sjgray/OSI600D-colour/_pics/Render-top.jpg

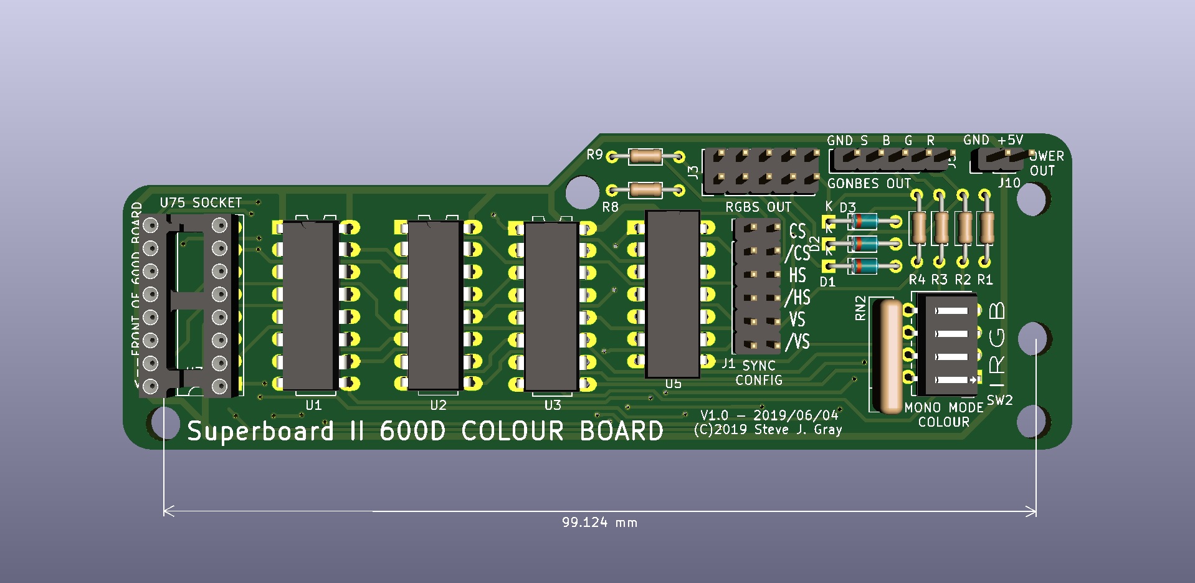
_pics/Render-top.jpg
