sjgray/OSI600D-colour/_pics/Proto1.jpg

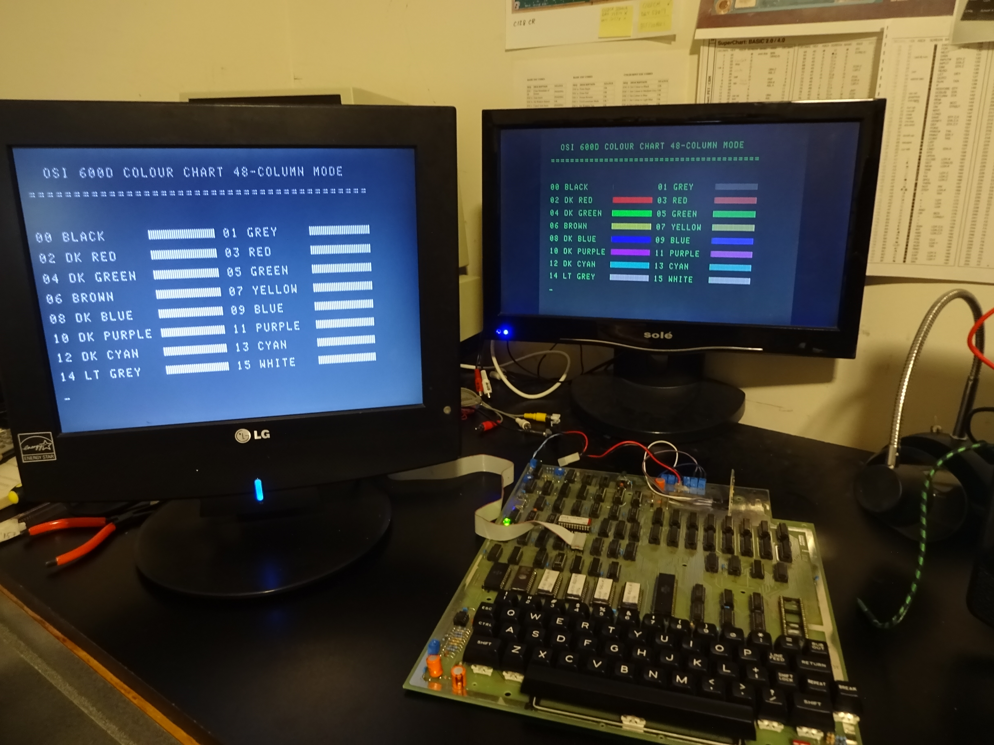
_pics/Proto1.jpg
