sjgray/OSI600D-colour/_pics/ColourChart-24.jpg

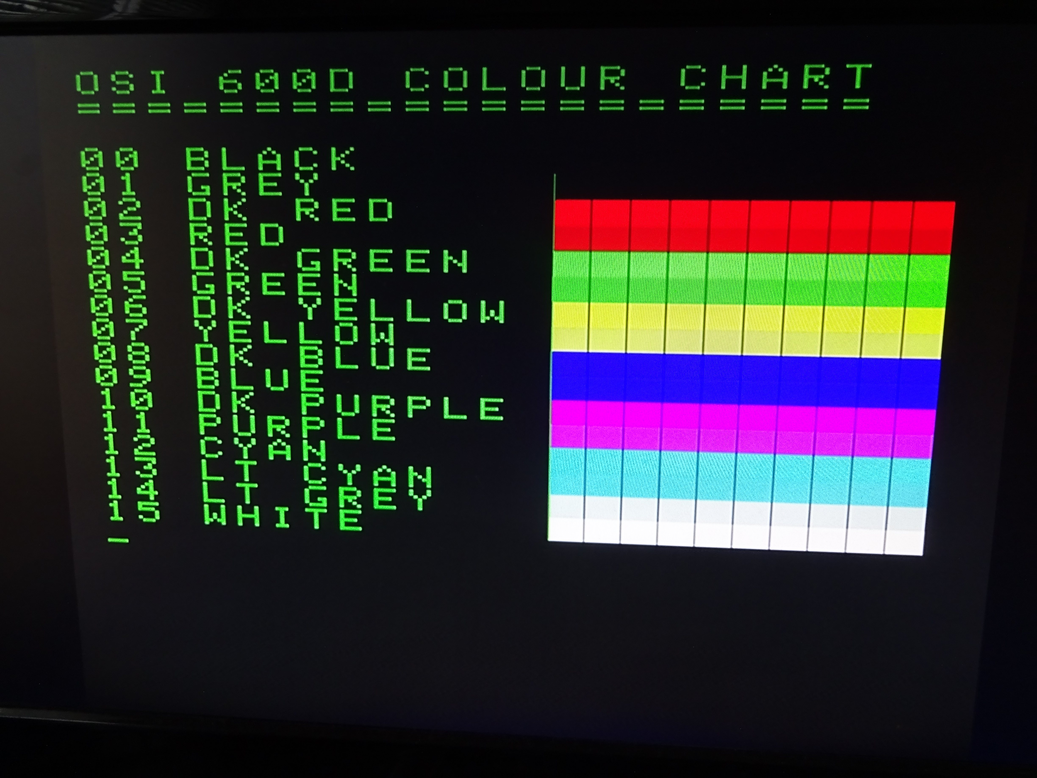
_pics/ColourChart-24.jpg
