sjgray/OSI600D-colour/_pics/ColourChart-48.jpg

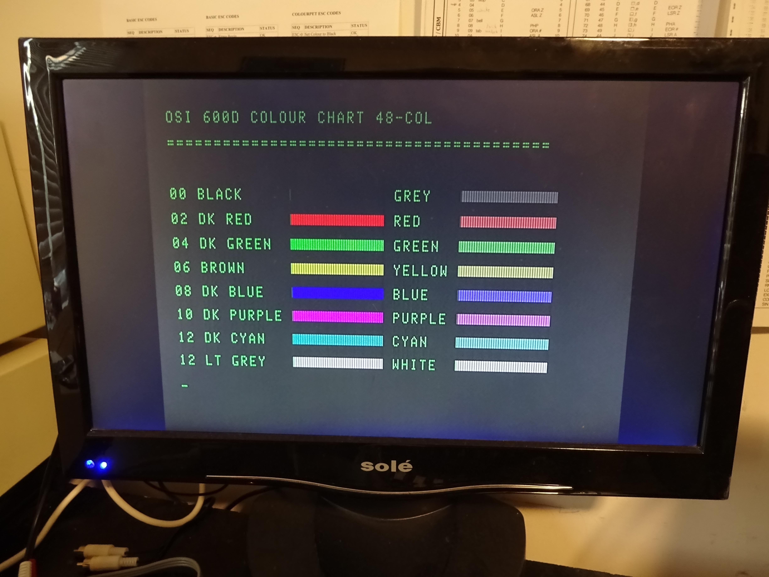
_pics/ColourChart-48.jpg
