sjgray/OSI600D-colour/_pics/Jumper.jpg

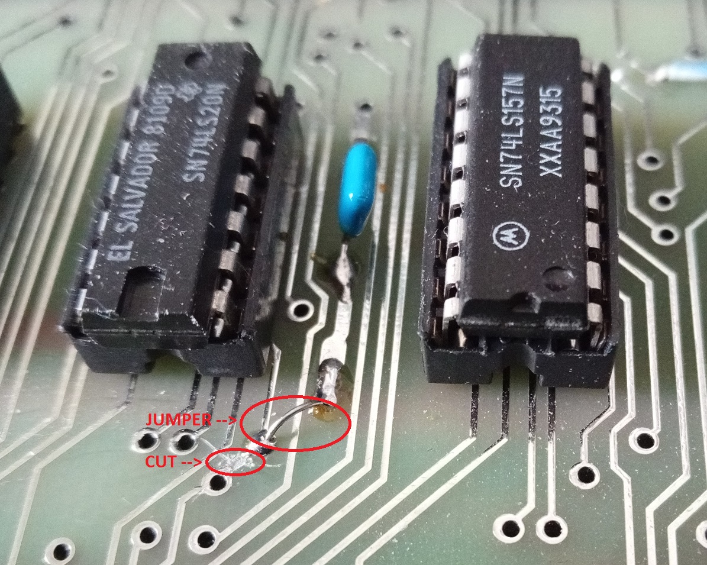
_pics/Jumper.jpg
