sjgray/OSI600D-colour/_pics/Render-angle.jpg

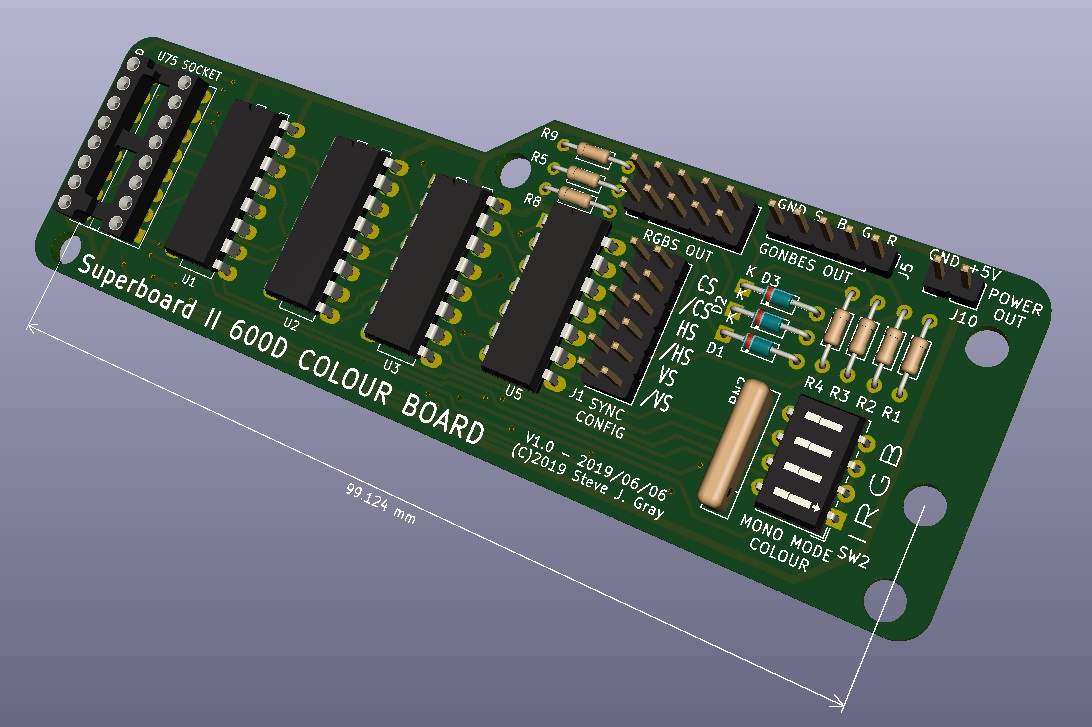
_pics/Render-angle.jpg
