sjgray/OSI600D-colour/_pics/Routing.jpg

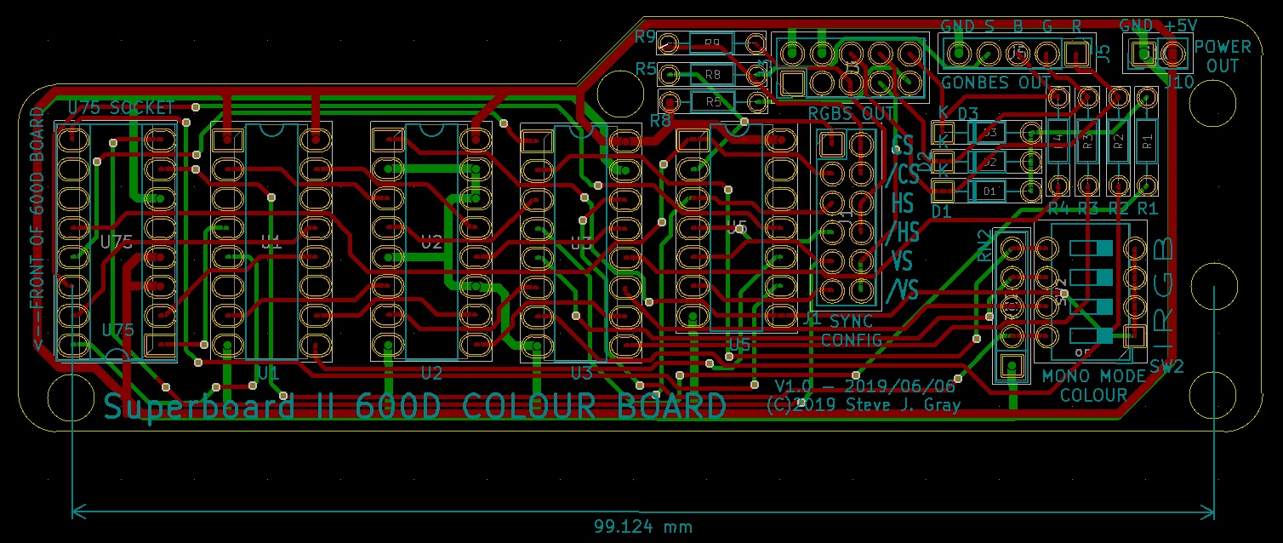
_pics/Routing.jpg
