sjgray/OSI600D-colour/_pics/Schematic.jpg

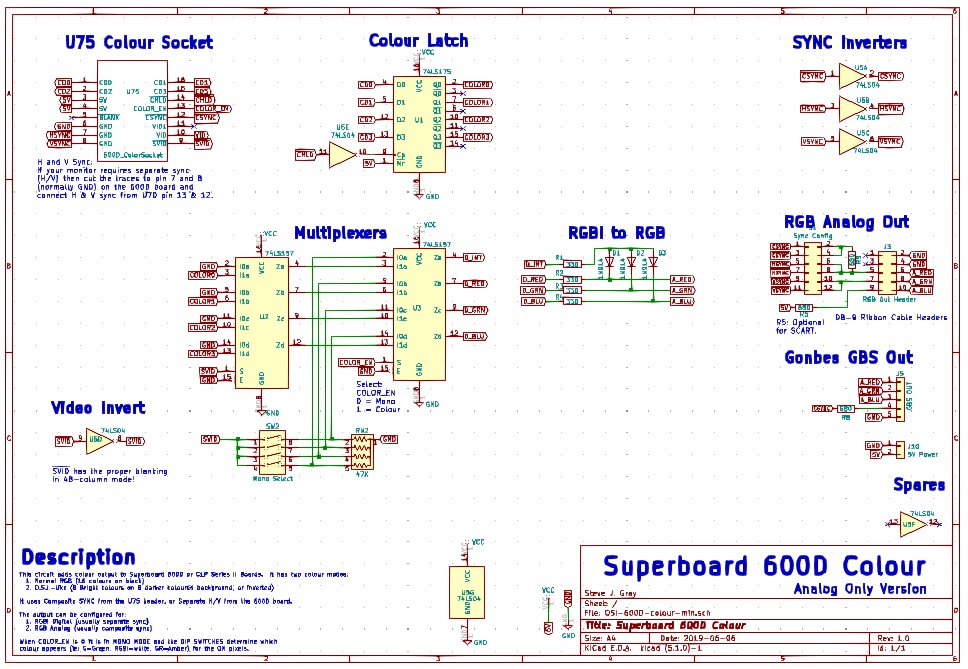
_pics/Schematic.jpg
