sjgray/OSI600D-colour/_pics/WinOSI C4P-Composite vs 600D-RGB.jpg

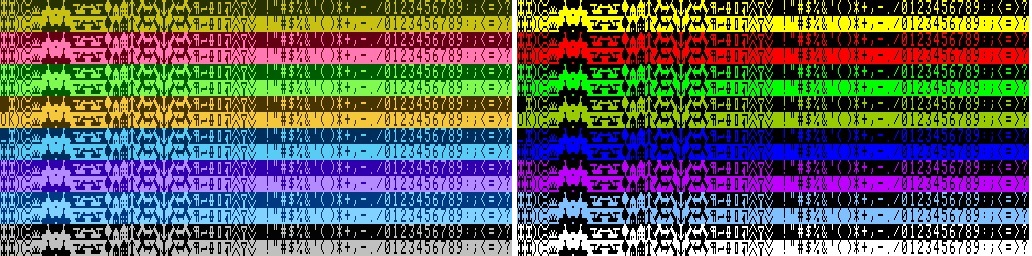
_pics/WinOSI C4P-Composite vs 600D-RGB.jpg
