sjgray/OSI600D-colour/OSI-600D-colour-min.pdf

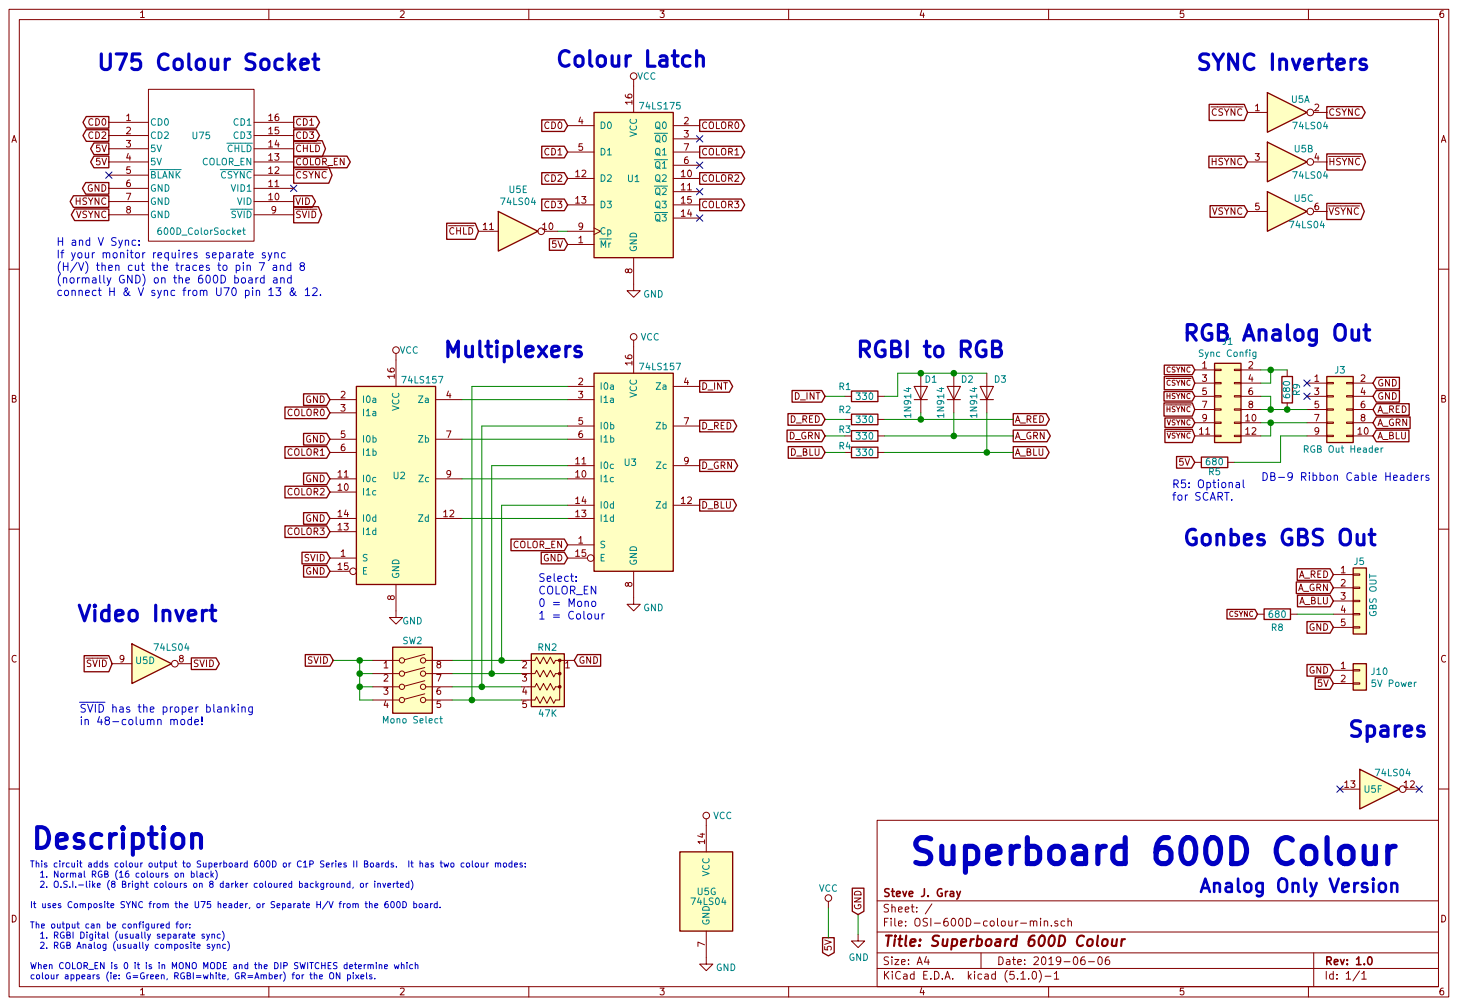
[picture p10: page 1]

VSYNC DB-9 Ribbon Cable Headers HSYNC

COLOR1 COLOR2 COLOR3 H and V Sync:
If your monitor requires separate sync
(H/V) then cut the traces to pin 7 and 8
(normally GND) on the 600D board and

Id: 1/1 Title: Superboard 600D Colour File: OSI-600D-colour-min.sch Sheet: / Steve J. Gray S

5V Video Invert
680 SVID has the proper blanking

This circuit adds colour output to Superboard 600D or C1P Series II Boards. It has two colour modes:
1. Normal RGB (16 colours on black)
2. O.S.I.-like (8 Bright colours on 8 darker coloured background, or inverted)

It uses Composite SYNC from the U75 header, or Separate H/V from the 600D board. The output can be configured for:
1. RGBI Digital (usually separate sync)
2. RGB Analog (usually composite sync) When COLOR_EN is 0 it is in MONO MODE and the DIP SWITCHES determine which
