sjgray/OSI600D-colour/OSI-600D-colour-min.kicad_pcb

## KiCad design OSI-600D-colour-min.kicad_pcb (2026-10-29)

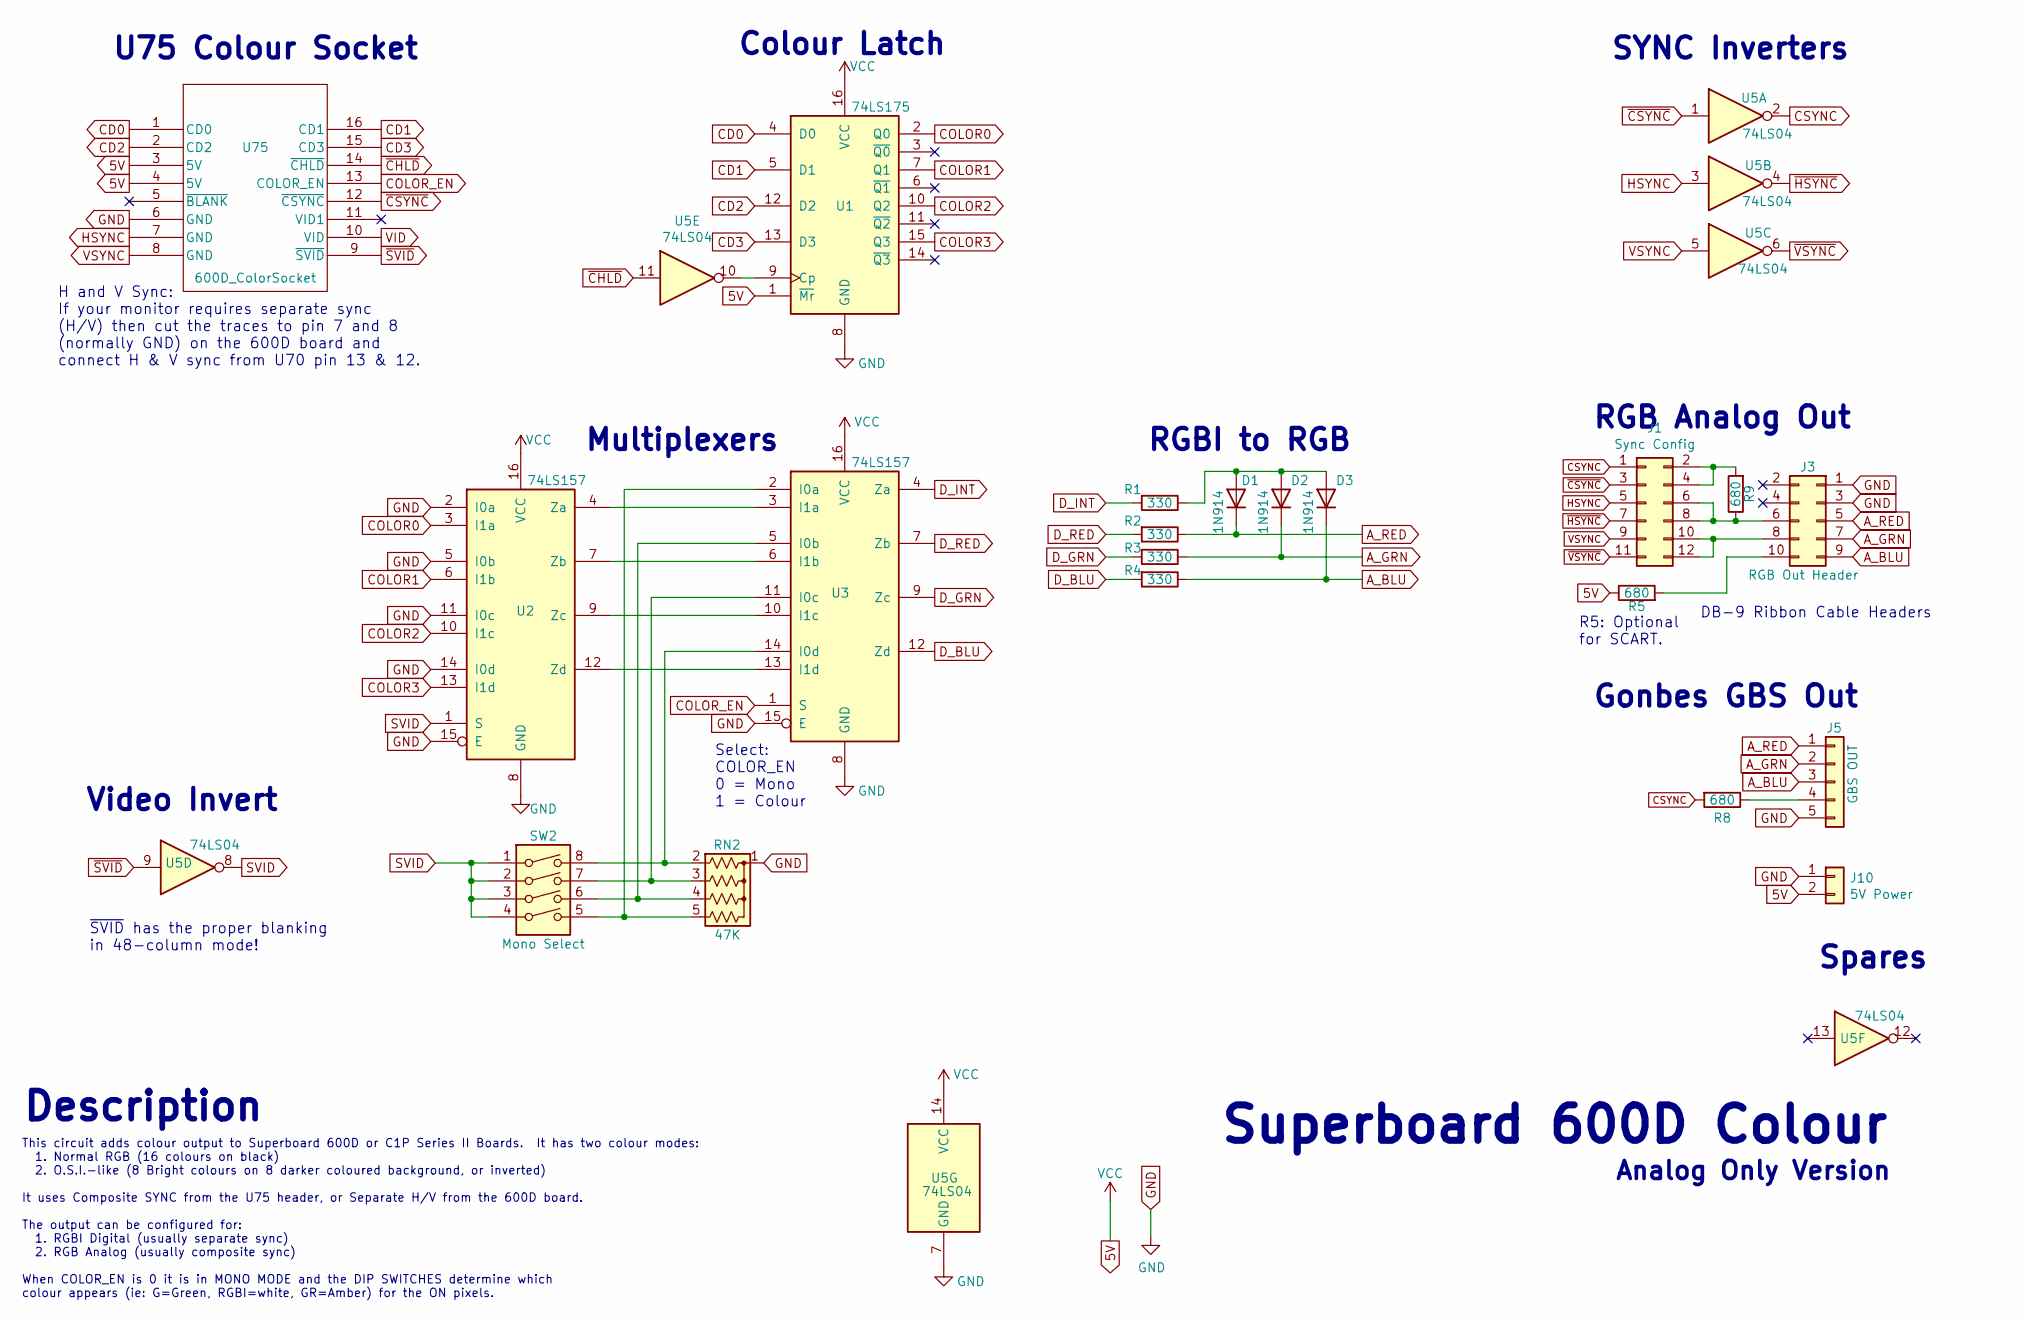
[picture p11: schematic OSI-600D-colour-min.kicad_sch, Superboard 600D Colour]

Parts:
D1, D2, D3: 1N914; D_DO-34_SOD68_P7.62mm_Horizontal
J1: Sync Config; PinHeader_2x06_P2.54mm_Vertical
J3: RGB Out Header; PinHeader_2x05_P2.54mm_Vertical
J5: GBS OUT; PinHeader_1x05_P2.54mm_Vertical
J10: 5V Power; PinHeader_1x02_P2.54mm_Vertical
R1, R2, R3, R4: 330; R_Axial_DIN0204_L3.6mm_D1.6mm_P7.62mm_Horizontal
R5, R8, R9: 680; R_Axial_DIN0204_L3.6mm_D1.6mm_P7.62mm_Horizontal
RN2: 47K; R_Array_SIP5
SW2: Mono Select; SW_DIP_SPSTx04_Slide_6.7x11.72mm_W7.62mm_P2.54mm_LowProfile
U1: 74LS175; DIP-16_W7.62mm_LongPads
U2, U3: 74LS157; DIP-16_W7.62mm_LongPads
U5: 74LS04; DIP-14_W7.62mm_LongPads
U75: 600D_ColorSocket; DIP-16_W7.62mm_Socket_LongPads

Connections:
5V: J10.2, R5.1, U1.1 (~Mr), U1.16 (VCC), U2.16 (VCC), U3.16 (VCC), U5.14 (VCC), U75.3 (5V), U75.4 (5V)
A_BLU: D3.1 (K), J3.9, J5.3, R4.1
A_GRN: D2.1 (K), J3.7, J5.2, R3.1
A_RED: D1.1 (K), J3.5, J5.1, R2.1
CD0: U1.4 (D0), U75.1 (CD0)
CD1: U1.5 (D1), U75.16 (CD1)
CD2: U1.12 (D2), U75.2 (CD2)
CD3: U1.13 (D3), U75.15 (CD3)
COLOR0: U1.2 (Q0), U2.3 (I1a)
COLOR1: U1.7 (Q1), U2.6 (I1b)
COLOR2: U1.10 (Q2), U2.10 (I1c)
COLOR3: U1.15 (Q3), U2.13 (I1d)
COLOR_EN: U3.1 (S), U75.13 (COLOR_EN)
CSYNC: J1.1, R8.2, U5.2
D_BLU: R4.2, U3.12 (Zd)
D_GRN: R3.2, U3.9 (Zc)
D_INT: R1.2, U3.4 (Za)
D_RED: R2.2, U3.7 (Zb)
GND: J3.1, J3.3, J5.5, J10.1, RN2.1 (common), U1.8 (GND), U2.2 (I0a), U2.5 (I0b), U2.8 (GND), U2.11 (I0c), U2.14 (I0d), U2.15 (E), U3.8 (GND), U3.15 (E), U5.7 (GND), U75.6 (GND)
HSYNC: J1.5, U5.3, U75.7 (GND)
unnamed: D1.2 (A), D2.2 (A), D3.2 (A), R1.1
unnamed: J1.2, J1.4, R9.2
unnamed: J1.6, J1.8, J3.6, R9.1
unnamed: J1.10, J1.12, J3.8
unnamed: J3.10, R5.2
unnamed: J5.4, R8.1
unnamed: RN2.2 (R1), SW2.8, U3.14 (I0d)
unnamed: RN2.3 (R2), SW2.7, U3.11 (I0c)
unnamed: RN2.4 (R3), SW2.6, U3.5 (I0b)
unnamed: RN2.5 (R4), SW2.5, U3.2 (I0a)
unnamed: U1.9 (Cp), U5.10
unnamed: U2.4 (Za), U3.3 (I1a)
unnamed: U2.7 (Zb), U3.6 (I1b)
unnamed: U2.9 (Zc), U3.10 (I1c)
unnamed: U2.12 (Zd), U3.13 (I1d)
SVID: SW2.1, SW2.2, SW2.3, SW2.4, U2.1 (S), U5.8
VSYNC: J1.9, U5.5, U75.8 (GND)
~CHLD: U5.11, U75.14 (~CHLD)
~CSYNC: J1.3, U5.1, U75.12 (~CSYNC)
~HSYNC: J1.7, U5.4
~SVID: U5.9, U75.9 (~SVID)
~VSYNC: J1.11, U5.6

Notes on the sheet:
R5: Optional for SCART.
RGB Analog Out
Analog Only Version
Gonbes GBS Out
RGBI to RGB
U75 Colour Socket
H and V Sync: If your monitor requires separate sync (H/V) then cut the traces to pin 7 and 8 (normally GND) on the 600D board and connect H & V sync from U70 pin 13 & 12.
Superboard 600D Colour
Multiplexers
Colour Latch
Spares
~{SVID} has the proper blanking in 48-column mode!
SYNC Inverters
Description
DB-9 Ribbon Cable Headers
Select: COLOR_EN 0 = Mono 1 = Colour
This circuit adds colour output to Superboard 600D or C1P Series II Boards. It has two colour modes: 1. Normal RGB (16 colours on black) 2. O.S.I.-like (8 Bright colours on 8 darker coloured background, or inverted) It uses Composite SYNC from the U75 header, or Separate H/V from the 600D board. Th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
Video Invert

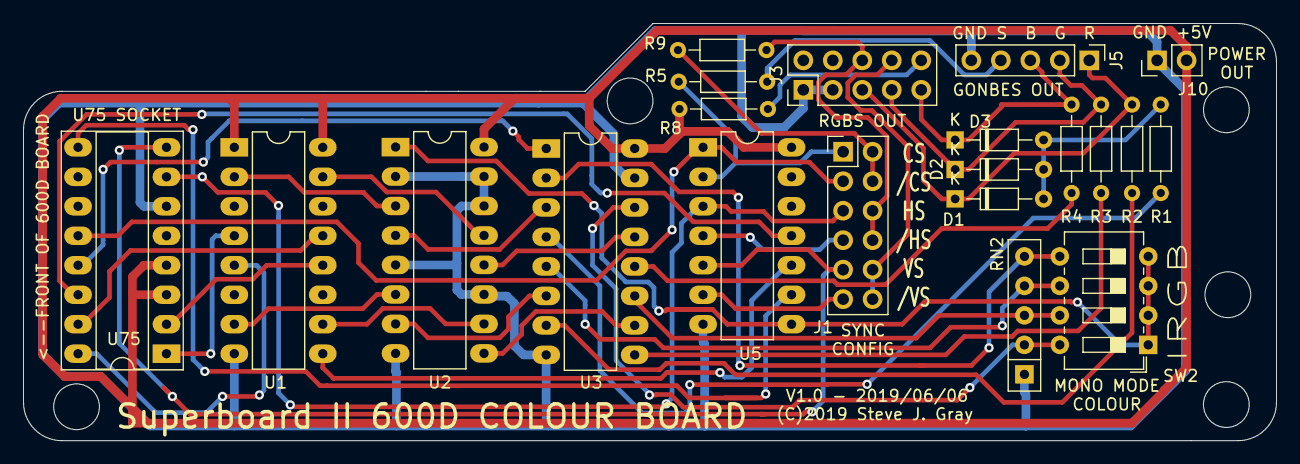
[picture p12: board OSI-600D-colour-min.kicad_pcb from above]

Board: 2 copper layers, 107.9 x 35.9 mm, 21 parts (0 on the bottom side), 42 nets.
