sjgray/OSI600D-colour/(commit log)

2026-10-29 Initial Release
    Somehow I forgot to post this on Github. I have loaded this into the newest Kicad and re-saved it, but otherwise this is the same as when I first made PCBs from DirtyPCB. I now use JLCPCB so you may need to create new gerbers for whatever service you use.
    [OSI-600D-colour-min.kicad_pcb, OSI-600D-colour-min.kicad_sch, OSI-600D-colour-min.sch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]
2026-10-29 Add Pictures
    Add pcb cut and jumper pic, plus pic of the board installed.
