sjgray/OSI600D-colour/(notices)

Notices in the files:
OSI-600D-colour-min.kicad_pcb:
(C)2019 Steve J. Gray
